uiuc-alec/ece445_dough_monitor/README.md

# ECE 445 Dough Monitoring Device

Repository and Electronic Lab Notebook for the SP24 Dough Monitor ECE 445 team

## Overview

The dough monitor is intended to be a device that can attach to most any enclosures (tubs, jars, etc.) to monitor the height and temperature of the dough or starter as it is rising. By calibrating the device at the start of the process, the e-Paper display will show the temperature, lowest height, current height, and max height. This will help users know if their dough or starter is at the right temperature and when it is ready to be cooked or used for other purposes.

Team Members:  

* [Jake Hayes](<https://github.com/compileriot>)  
	* [Jake's lab notebook](<https://github.com/uiuc-alec/ece445_dough_monitor/tree/main/notebooks/jake>)  
* [Abhitya Krishnaraj](<https://github.com/abhityakrishnaraj>)  
	* [Abhitya's lab notebook](<https://github.com/uiuc-alec/ece445_dough_monitor/tree/main/notebooks/abhitya>)  
* [Alec Thompson](<https://github.com/uiuc-alec>)  
	* [Alec's lab notebook](<https://github.com/uiuc-alec/ece445_dough_monitor/tree/main/notebooks/alec>)  

### Doc links:
- [RFA](<https://docs.google.com/document/d/1kF1rHTl5g_Uzm8IN8ehcqM2Bl3i7Av3ugFFKGpFKIh4/edit?usp=sharing>)
- [Project Proposal](<https://docs.google.com/document/d/1TKZvJ8-ajKKCzJN4BzpvQgP6Wtzp_BtlWftU6C2UMDA/edit?usp=sharing>)
- [Design Document](<https://docs.google.com/document/d/1KsPt3ziOBMEgM2YeDxTdxmcEFOSrHt8D0JKil-PqETM/edit?usp=sharing>)
- [Final Presentation](<https://docs.google.com/presentation/d/1yKvjIHg_gXwxNNr-S3OlODOh9tRP3artU0gckCc1C8s/edit?usp=sharing>)
- [Final Paper](<https://uillinoisedu-my.sharepoint.com/:w:/g/personal/abhitya2_illinois_edu/EYfktbYTXWlAkdfkIiclUBoBDbqpY0NMi2pT171NzSJxXw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>)
- [Demo video](<https://www.youtube.com/embed/4N0sI_6v96w?si=lUEZGT0_BrroQvX6>)
