uiuc-alec/ece445_dough_monitor/code/README.md

# Code
This directory will contain the code for the microcontroller and for the stretch goal of making this device remotely accessible.

The CubeIDE_Projects Directory contains whole project directories for the CubeIDE projects. Find the modified main.c files in the Core/Src/ directory.
