uiuc-alec/ece445_dough_monitor/boards/README.md

# Boards
This directory will contain important information and PCB files for the physical side of our project.
