uiuc-alec/ece445_dough_monitor/notebooks/jake/README_files/School/ECE_445/README/pasted_image008.png

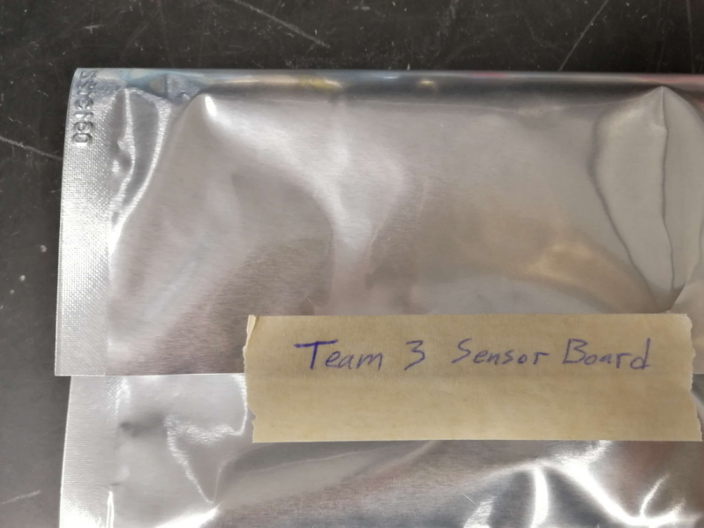
notebooks/jake/README_files/School/ECE_445/README/pasted_image008.png
