uiuc-alec/ece445_dough_monitor/code/CubeIDE_Projects/Sensors_v1.1_corefiles/Src/main.c

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
/* Includes ------------------------------------------------------------------*/
#include "main.h"

ADC_HandleTypeDef hadc1;

I2C_HandleTypeDef hi2c1;

UART_HandleTypeDef huart2;

/* USER CODE BEGIN PV */
static const uint8_t VCNL_ADDR = 0x60 << 1;
static const uint8_t REG_DIST = 0X08;

/* USER CODE END PV */

void SystemClock_Config(void);
static void MX_GPIO_Init(void);
static void MX_ADC1_Init(void);
static void MX_I2C1_Init(void);
/* USER CODE BEGIN 0 */
uint8_t TX_Buffer[] = "A";

/* USER CODE END 0 */

/**
 * @brief  The application entry point.
 * @retval int
 */
int main(void) {
	/* USER CODE BEGIN 1 */
	HAL_StatusTypeDef ret;
	uint32_t adcval; //adc value from temp sensor
	float tempC; //variable to hold temperature in Celcius
	float tempF; //variable to hold temperature in Farenheit
	uint8_t buf[2];
	uint8_t buf2[2];
	int16_t val;
	float distin;
	float distcm;
	float dist_transform;

	/* USER CODE END 1 */

	/* MCU Configuration--------------------------------------------------------*/

	/* Reset of all peripherals, Initializes the Flash interface and the Systick. */
	HAL_Init();

	/* Configure the system clock */
	SystemClock_Config();

	/* Initialize all configured peripherals */
	MX_GPIO_Init();
	MX_ADC1_Init();
	MX_I2C1_Init();
	/* Infinite loop */
	/* USER CODE BEGIN WHILE */
	while (1) {
		/* USER CODE END WHILE */

		/* USER CODE BEGIN 3 */
		HAL_ADC_Start(&hadc1);
		if (HAL_ADC_PollForConversion(&hadc1, 5) == HAL_OK) {
			adcval = HAL_ADC_GetValue(&hadc1);
			tempC = (adcval * 330.0) / 59070.0; // in Celcius
			tempF = (tempC * 9.0 / 5.0) + 32.0; // in Farenheit
		}
//		ret = HAL_I2C_Master_Transmit(&hi2c1, VCNL_ADDR, buf, 1, 1000);
//		if (ret != HAL_OK) {
//			strcpy((char*) buf, "Error Tx\r\n");
//		} else {
//
//			// Read 2 bytes from the temperature register
//			ret = HAL_I2C_Master_Receive(&hi2c1, VCNL_ADDR, buf, 2, 1000);
//			if (ret != HAL_OK) {
//				strcpy((char*) buf, "Error Rx\r\n");
//			} else {
//
//				//Combine the bytes
//				val = ((int16_t) buf[0] << 4) | (buf[1] >> 4);
//			}
//		}
		buf2[0] = 0x00;
		buf2[1] = 0x00;
		HAL_I2C_Mem_Write(&hi2c1, VCNL_ADDR, 0x03, I2C_MEMADD_SIZE_8BIT, buf2, 2, 100);
		buf2[0] = 0x00;
		buf2[1] = 0x07;
		HAL_I2C_Mem_Write(&hi2c1, VCNL_ADDR, 0x04, I2C_MEMADD_SIZE_8BIT, buf2, 2, 100);
		if (HAL_I2C_Mem_Read(&hi2c1, VCNL_ADDR, REG_DIST, I2C_MEMADD_SIZE_8BIT, buf, 2, 100) == HAL_OK) {
			val = ((int16_t) buf[1]) | (buf[0] << 8);
			double dist_transform;
			  if(val > 54528){//xd500
			    dist_transform = 3.5;
			  }
			  else if(val > 36864){//x9000
			    dist_transform = 4.0;
			  }
			  else if(val > 31232){//x7a00
			    dist_transform = 4.5;
			  }
			  else if(val > 26368){//x6700
			    dist_transform = 5.0;
			  }
			  else if(val > 23040){//x5a00
			    dist_transform = 5.5;
			  }
			  else if(val > 19712){//x4d00
			    dist_transform = 6.0;
			  }
			  else if(val > 17152){//x4300
			    dist_transform = 6.5;
			  }
			  else if(val > 14848){//x3a00
			    dist_transform = 7.0;
			  }
			  else if(val > 13312){//x3400
			    dist_transform = 7.5;
			  }
			  else if(val > 12032){//x2f00
			    dist_transform = 8.0;
			  }
			  else if(val > 10752){//x2a00
			    dist_transform = 8.5;
			  }
			  else if(val > 9472){//x2500
			    dist_transform = 9.0;
			  }
			  else if(val > 7936){//x1f00
			    dist_transform = 9.5;
			  }
			  else if(val > 7680){//x1e00
			    dist_transform = 10.0;
			  }
			  else if(val > 7168){//x1c00
			    dist_transform = 10.5;
			  }
			  else if(val > 6400){//x1900
			    dist_transform = 11.0;
			  }
			  else if(val > 5632){//x1600
			    dist_transform = 11.5;
			  }
			  else if(val > 5120){//x1400
			    dist_transform = 12.0;
			  }
			  else if(val > 4608){//x1200
			    dist_transform = 12.5;
			  }
			  else if(val > 4096){//x1000
			    dist_transform = 13.0;
			  }
			  else if(val > 3840){//x0f00
			    dist_transform = 14.0;
			  }
			  else if(val > 3584){//x0e00
			    dist_transform = 15.0;
			  }
			  else if(val > 3072){//x0c00
			    dist_transform = 16.0;
			  }
			  else if(val > 4096){//x0b00
			    dist_transform = 17.0;
			  }
			  else if(val > 3840){//x0a00
			    dist_transform = 18.0;
			  }
			  else if(val > 3584){//x0900
			    dist_transform = 19.0;
			  }
			  else if(val > 3072){//x0800
			    dist_transform = 20.0;
			  }
			  else if(val > 3584){//x0700
			    dist_transform = 21.0;
			  }
			  else if(val > 3072){//x0600
			    dist_transform = 23.0;
			  }
			  else{
			    dist_transform = 25.0;
			  }
		} else {
			strcpy((char*) buf, "Error\r\n");
		}
		/* USER CODE END 3 */
	}
}

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
