uiuc-alec/ece445_dough_monitor/(commit log)

2024-04-01 Added distance sensor code for Arduino
2024-04-07 modified displays code for sensor readings
2024-04-09 Implemented the state machine and button input in the code. Needs tested
2024-04-09 added getDistance call to current_height
2024-04-15 Update arduino_implementation.ino for dist_transform
