uiuc-alec/ece445_dough_monitor/(notices)

Notices in the files:
code/CubeIDE_Projects/Sensors_v1.1_corefiles/Src/main.c:
Copyright (c) 2024 STMicroelectronics.
All rights reserved.
This software is licensed under terms that can be found in the LICENSE file
